syskaseb/robot-cat/hardware/wavego/README.md

# WAVEGO FreeCAD model

`WAVEGO_PRO_BETA_v3.FCStd` is the coloured, non-animated source model.
`WAVEGO_PRO_BETA_v3_motion.FCStd` is its 12-DOF kinematic working copy.

`WAVEGO_component_layout.FCStd` is a separate component-packaging study,
with 26 installation envelopes, measured attachment axes and camera FOV.
See [layout/README.md](layout/README.md) for dimensions, the proposed raised
back, component provenance and collision-test limits. Its coloured boxes
and wireframe enclosures are **not printable mechanical parts**.

`WAVEGO_cat_mechanical.FCStd` is the subsequent PETG mechanical prototype:
a three-part ventilated trunk, the head with its face mask and camera carrier,
the neck saddle, and a servo-driven four-segment tail. It is a work-in-progress
checkpoint, **not released for printing** — see
[mechanics/README.md](mechanics/README.md) for what is and is not verified.
The layout study's clearance results do not certify this later mechanical model.

Every `CAT_*` body in it is generated by
[tools/freecad/wavego_cat_shell.py](../../tools/freecad/wavego_cat_shell.py),
so the geometry is reviewable as a parameter diff and cannot be lost on save.
Rebuild it, and the previews, with:

```bash
freecadcmd tools/freecad/wavego_cat_shell.py
freecadcmd tools/freecad/wavego_cat_render.py
```

Note that `layout/components.json` and `mechanics/components.json` share ids but
**not coordinates** — the layout study's frame is rotated 180 degrees about the
vertical through X=21. The mechanical model uses the one in `mechanics/`.

## Run the motion preview in FreeCAD

1. Open `WAVEGO_PRO_BETA_v3_motion.FCStd`.
2. Run `tools/freecad/WAVEGO_Motion.FCMacro` from **Macro > Macros**.
3. Use the **WAVEGO Motion** dock:
   - **Play trot / Pause** starts or stops the diagonal gait preview;
   - **Stand** restores the imported neutral pose;
   - **Gait phase** scrubs the animation;
   - the 12 numeric fields adjust each servo joint manually;
   - **Show servo axes** displays hip, knee and ankle axes in red, green and blue.

The preview checks hierarchy, ranges and clearances visually. It does not
simulate mass, torque, collisions, ground contact or servo dynamics; those
belong in the ROS 2 / Gazebo model after the CAD motion is accepted.

## Leg/servo mapping

| Leg | Hip | Knee | Ankle |
|---|---:|---:|---:|
| Front right (FR) | 4 | 6 | 10 |
| Front left (FL) | 3 | 8 | 12 |
| Rear right (RR) | 1 | 5 | 9 |
| Rear left (RL) | 2 | 7 | 11 |

The macro is idempotent: running it again reuses the existing kinematic
groups and reopens the controller panel.

## Rigid servo mount correction

Both servo cases in each leg share a rigid group with its two LegLinks.
The upper servo horns are fixed to WConnector; the lower servo horns and
LegSpacer are fixed to the foot bracket. Only the shaft joints articulate.
The macro also migrates the earlier, incorrect hierarchy at the neutral pose.

Verified in FreeCAD: 32 rigid part pairs over 25 gait phases retained their
relative transforms (maximum translation error 5.95e-13 mm, rotation 0 degrees).
Rebuilding from a moving pose also passed. This checks assembly attachment
integrity; it does not certify the imported hole fit or collision clearance.
