syskaseb/robot-cat/hardware/wavego/layout/baseline.png

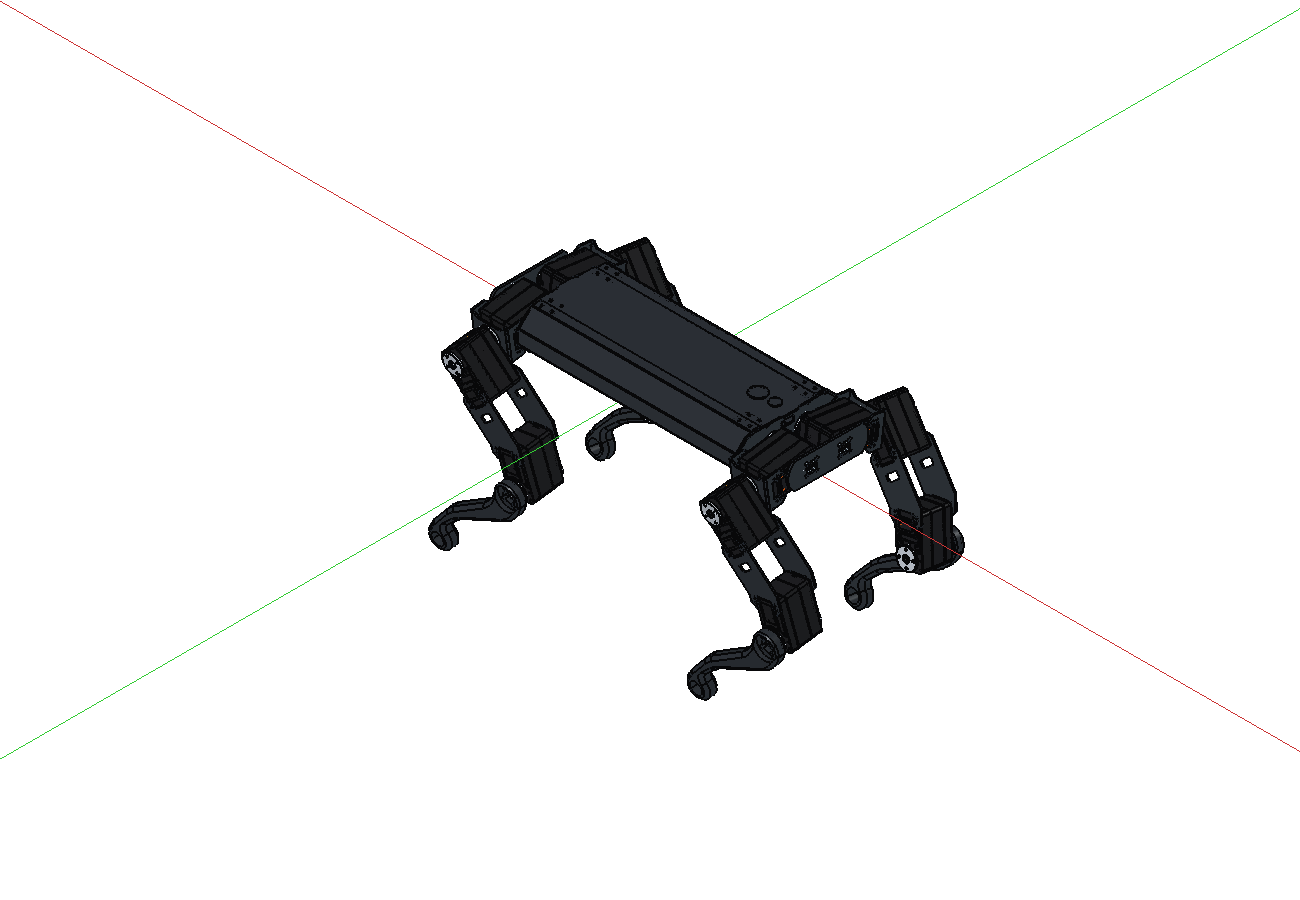
hardware/wavego/layout/baseline.png
