syskaseb/robot-cat/hardware/wavego/layout/layout-head.png

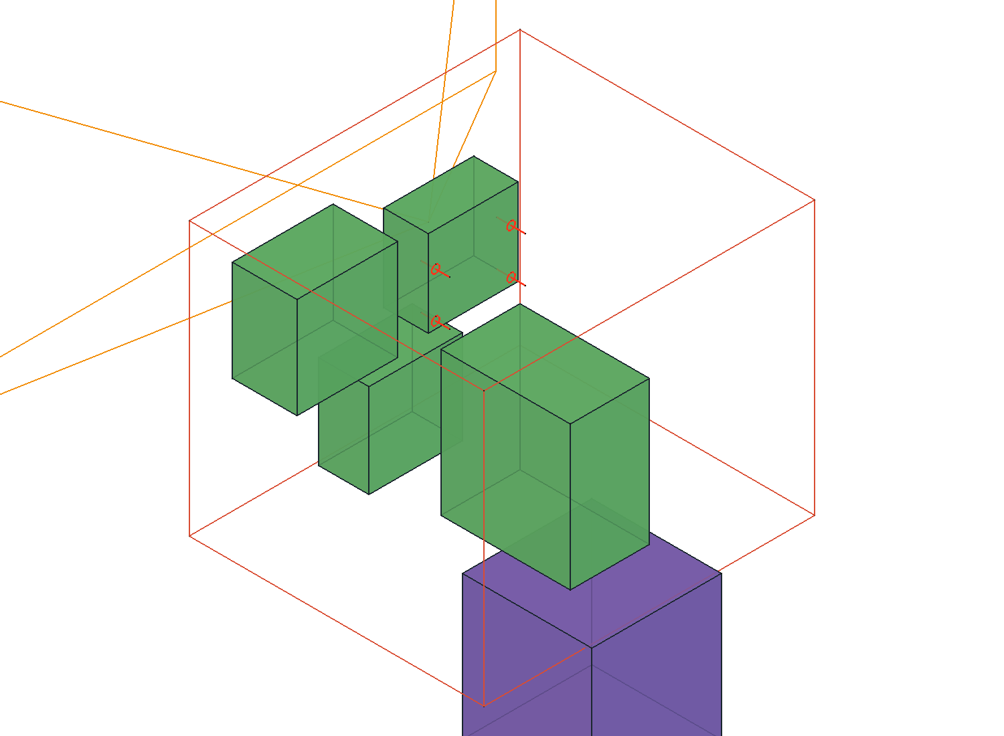
hardware/wavego/layout/layout-head.png
