syskaseb/robot-cat/hardware/wavego/layout/layout-isometric.png

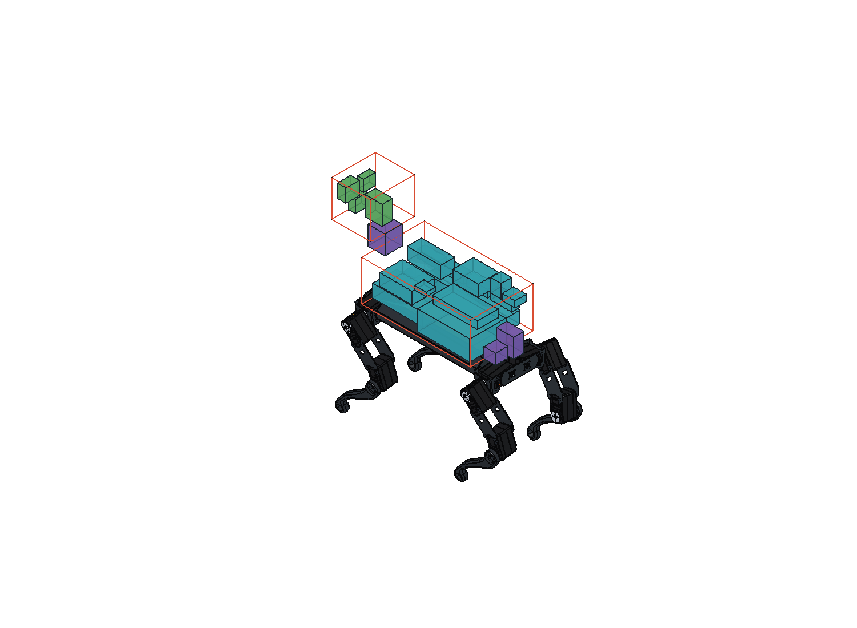
hardware/wavego/layout/layout-isometric.png
