syskaseb/robot-cat/hardware/wavego/layout/layout-lower.png

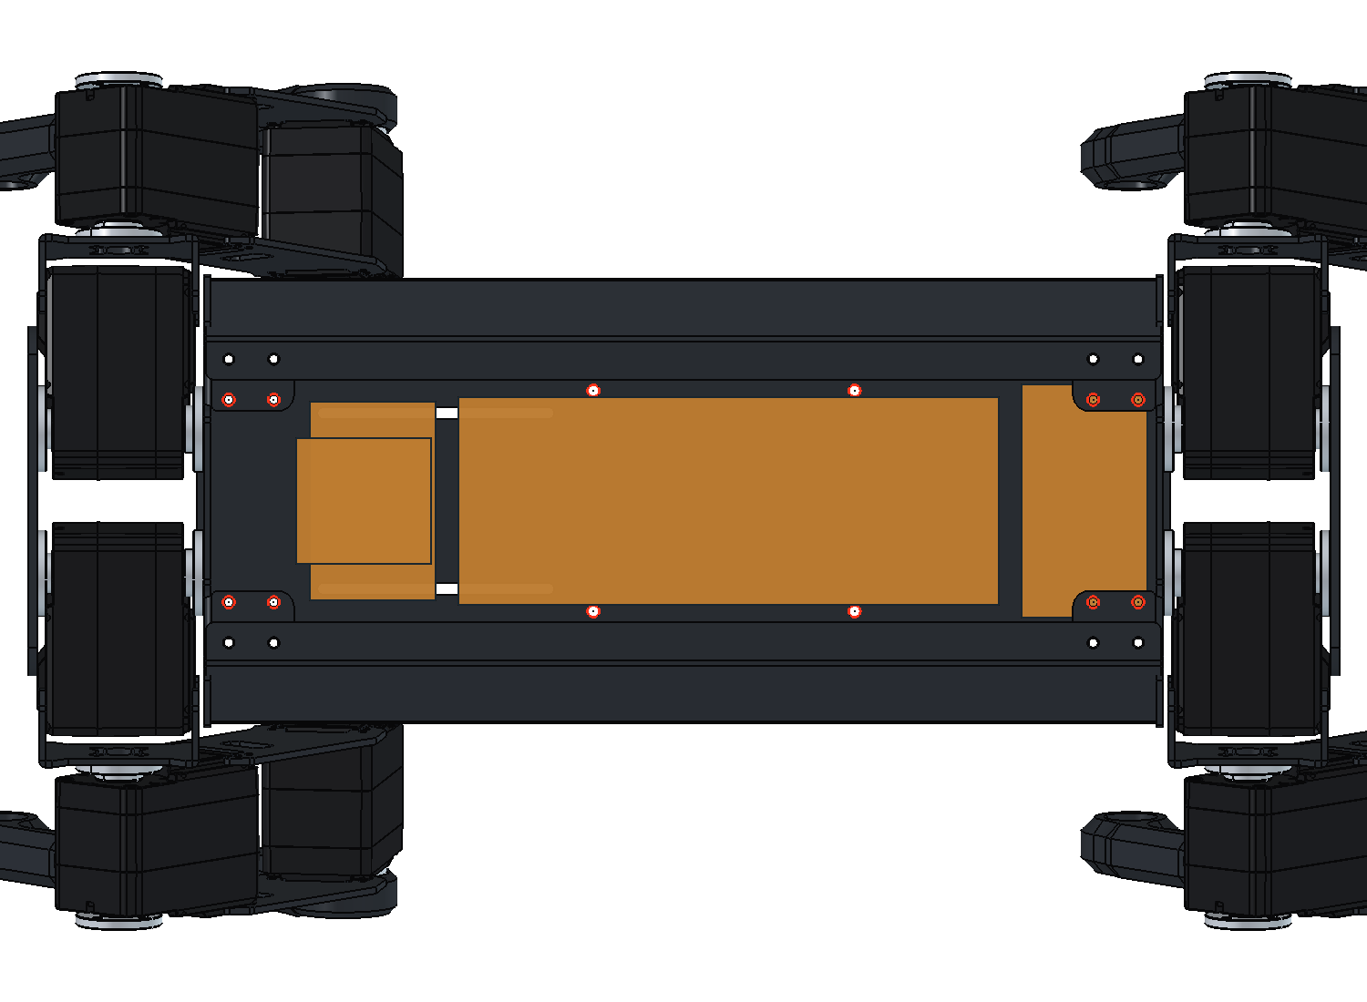
hardware/wavego/layout/layout-lower.png
