syskaseb/robot-cat/hardware/wavego/layout/layout-side.png

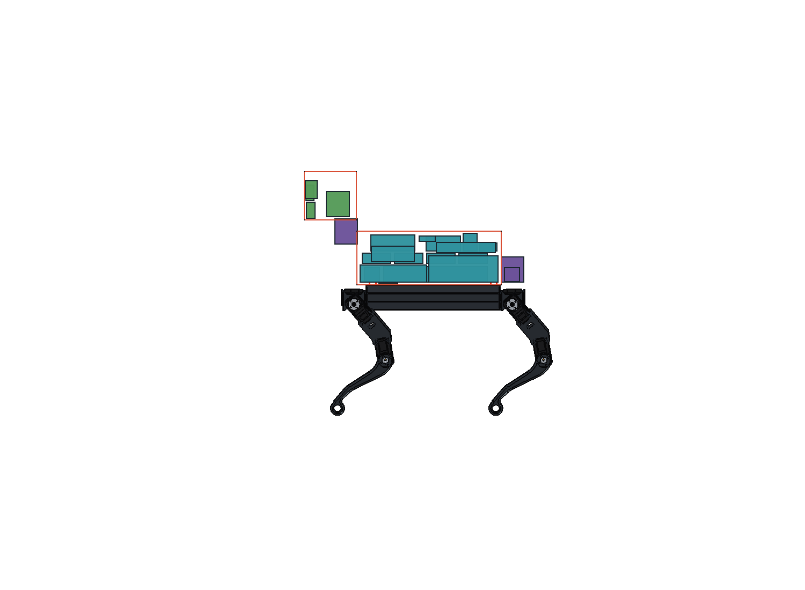
hardware/wavego/layout/layout-side.png
