syskaseb/robot-cat/hardware/wavego/layout/mechanics-progress.png

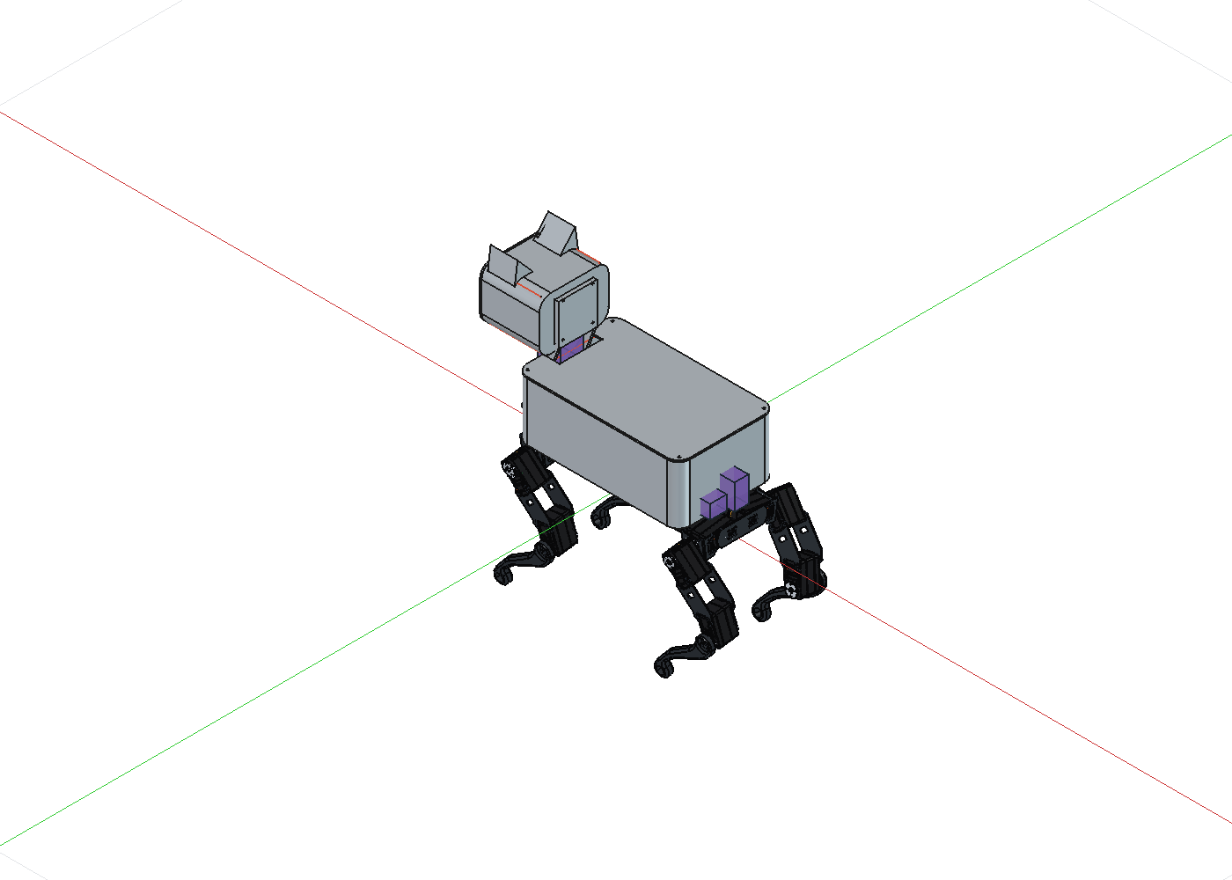
hardware/wavego/layout/mechanics-progress.png
