syskaseb/robot-cat/hardware/wavego/source/robot-cat-backup.png

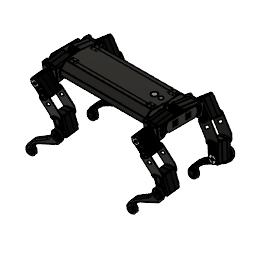
hardware/wavego/source/robot-cat-backup.png
