syskaseb/robot-cat/hardware/wavego/WAVEGO_FreeCAD_iso.png

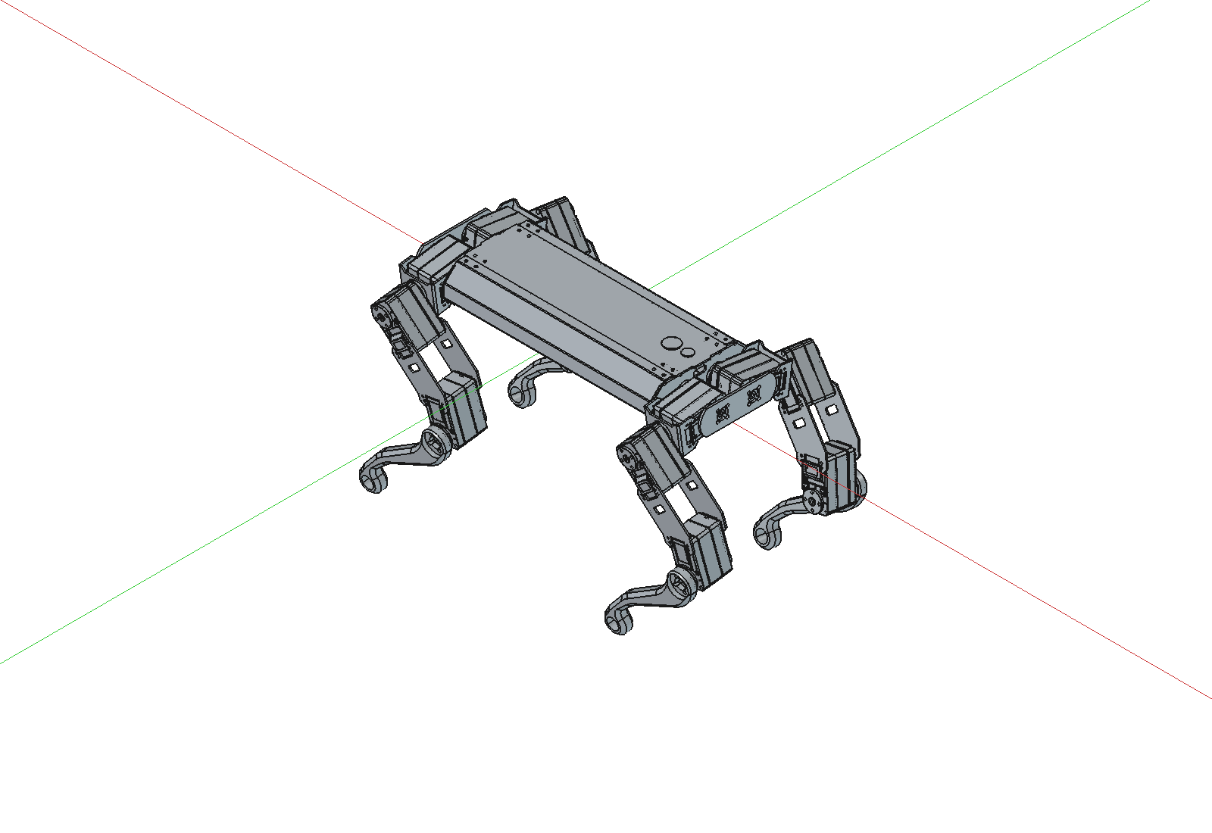
hardware/wavego/WAVEGO_FreeCAD_iso.png
