syskaseb/robot-cat/hardware/wavego/WAVEGO_FreeCAD_materials.png

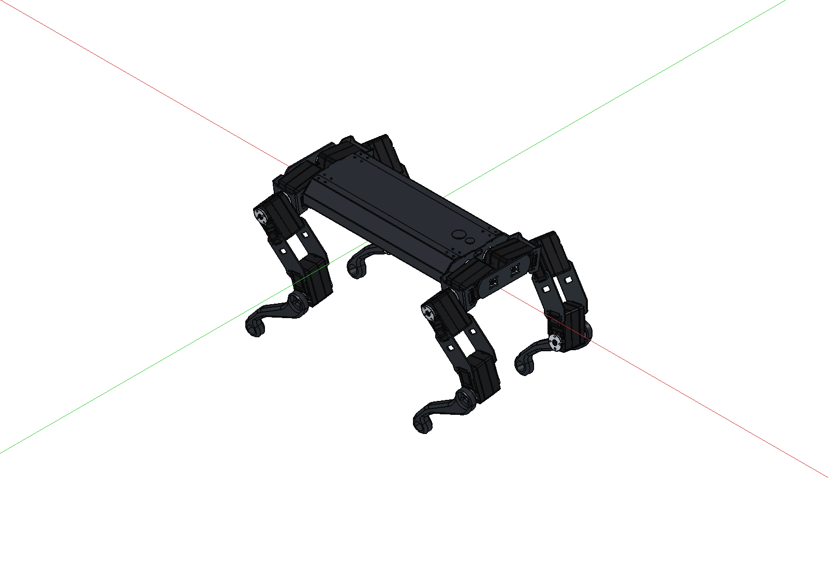
hardware/wavego/WAVEGO_FreeCAD_materials.png
