syskaseb/robot-cat/hardware/wavego/source/WAVEGO_PRO_BETA_v3.step

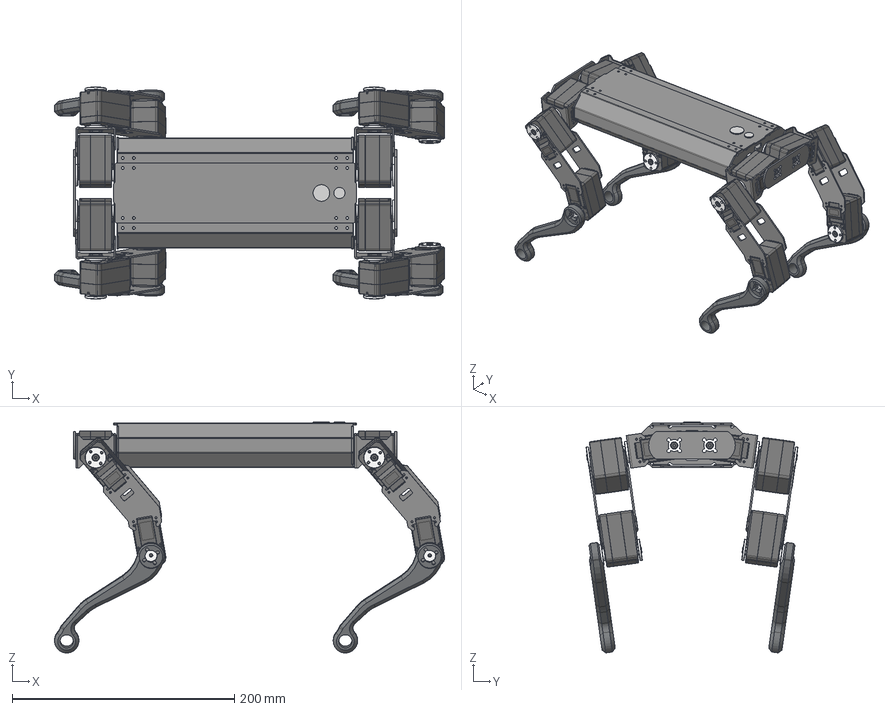
[picture p16: CAD file, 2026-09-04]
hardware/wavego/source/WAVEGO_PRO_BETA_v3.step
351.0 x 190.7 x 207.8 mm
前后盖板 x 2
腿部垫片 x 4
主结构 x 2
侧面板 x 2
腿部连接件 x 8
上下盖板
ZK_122 x 12
SG-ZIJI_15 x 12
XG-ZIJI_16 x 12
MOTOR-1723_3 x 12
PCB-CHAZUO_92 x 12
GE_27 x 12
金属舵盘（驱动） x 12
金属舵盘（从动） x 12
上盖板
W连接件 x 4
支架 x 4
零部件9
