syskaseb/robot-cat/hardware/wavego/WAVEGO_cat_mechanical.FCStd

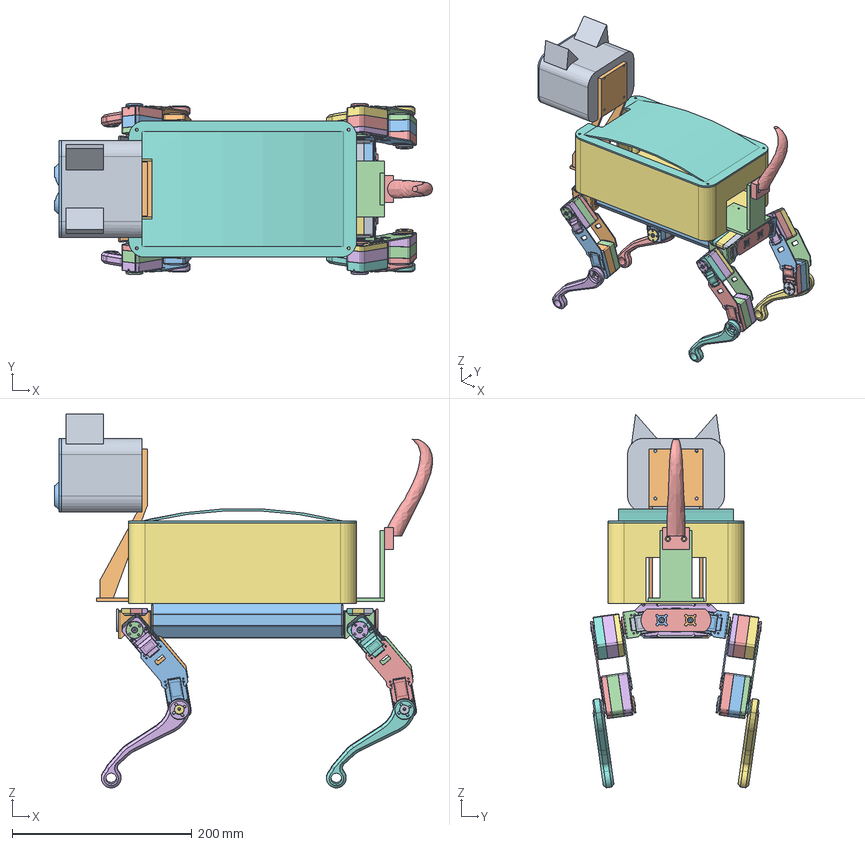
[picture p18: CAD file, 2026-09-09]
hardware/wavego/WAVEGO_cat_mechanical.FCStd
421.0 x 190.7 x 416.2 mm
FrontRearCover
MainFrame
SidePanel
TopBottomCover
ZK_122
SG-ZIJI_15
XG-ZIJI_16
MOTOR-1723_3
PCB-CHAZUO_92
GE_27
ZK_123
SG-ZIJI_001
XG-ZIJI_001
MOTOR-1723_001
PCB-CHAZUO_001
GE_001
ZK_124
SG-ZIJI_002
XG-ZIJI_002
MOTOR-1723_002
PCB-CHAZUO_002
GE_002
ZK_125
SG-ZIJI_003
XG-ZIJI_003
MOTOR-1723_003
PCB-CHAZUO_003
GE_003
FrontRearCover001
MainFrame001
SidePanel001
Bracket_v002
HornDisc_Drive_v009
HornDisc_Idle_v009
LegSpacer001
LegLink
LegLink001
ZK_127
SG-ZIJI_005
XG-ZIJI_005
MOTOR-1723_005
PCB-CHAZUO_005
GE_005
ZK_131
SG-ZIJI_009
XG-ZIJI_009
MOTOR-1723_009
PCB-CHAZUO_009
GE_009
HornDisc_Drive_v003
HornDisc_Idle_v003
WConnector002
HornDisc_Drive_v005
HornDisc_Idle_v005
Bracket_v003
HornDisc_Drive_v011
HornDisc_Idle_v011
LegSpacer003
LegLink002
LegLink003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
