syskaseb/robot-cat/(list of files, cad)

Other CAD files:
hardware/wavego/WAVEGO_PRO_BETA_v3_motion.FCStd
hardware/wavego/WAVEGO_PRO_BETA_v3_colored_backup.FCStd
hardware/wavego/WAVEGO_PRO_BETA_v3_backup.FCStd
hardware/wavego/WAVEGO_PRO_BETA_v3.FCStd
hardware/wavego/source/robot-cat-backup.f3d
