syskaseb/robot-cat/(commit log)

2026-08-20 Simulated quadruped robot cat with arrow-key teleop
    ROS 2 Jazzy + Gazebo Harmonic running natively on Apple Silicon via
    RoboStack, with a 12-DOF cat that walks a trot gait under keyboard control.
    - robot_cat_description: xacro model built from one parameterised leg macro,
    ros2_control wiring and the gz_ros2_control plugin
    - robot_cat_gait: analytic 3-DOF leg IK and trot generation, both ROS-free
    and unit tested, plus the node mapping /cmd_vel to twelve joint positions
    - robot_cat_teleop: arrow-key teleop, decoding split out as a pure function
    - robot_cat_bringup: world, launch files and a camera framed for a 30 cm robot
    Three macOS-specific settings live in pixi.toml and are needed for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
    [cat.ros2_control.xacro, cat.urdf.xacro, cat_world.sdf, controllers.yaml, inertia.xacro, leg.xacro]
2026-08-20 Add an agent-facing runbook and CLAUDE.md pointer
    Someone (or some agent) landing on this repo cold needs more than the human
    quick-start: exact readiness polling, how to drive the cat without a
    keyboard, how to verify motion from the pose rather than the viewport, and
    the gotchas that cost real time (orphaned gait_controller processes after a
    partial kill, set -u breaking colcon's setup.bash, yaw wraparound).
    CLAUDE.md exists only because Claude Code auto-loads it and not README.md -
    it is a short pointer into the Runbook section plus the handful of rules
    most likely to be missed on a first pass.
    🤖 AI Assisted with Claude Code
2026-08-22 Add head/tail teleop control and fix limping gait
    Adds W/A/S/D head pan/tilt and space-stepped tail control, each driven by
    its own ros2_control position controller. Fixes the visible limp that
    appeared once head/tail became actuated: Fast DDS's shared-memory transport
    silently drops /cmd_vel on this machine, tripping the gait watchdog
    mid-stride, so the project now runs on Cyclone DDS. Also rebalances body
    mass to recover the trunk pitch inertia that moved off fixed joints and
    onto the newly free head/tail bodies.
    [cat.ros2_control.xacro, cat.urdf.xacro, controllers.yaml]
2026-08-22 Add a walkable apartment world with a kitchen and living room
    New apartment_world.sdf drops in OpenRobotics' Fuel-hosted "Kitchen and
    Dining" and "Sofa" models (both CC0) so the cat has somewhere more
    interesting than a bare plane to walk. Selected via a new `world` launch
    argument on sim.launch.py; the plain arena remains the default.
    [apartment_world.sdf]
2026-08-22 Add first- and third-person camera views on the v key
    Third-person is Gazebo's own follow, parented behind the cat. First-person
    cannot use follow - follow always aims the camera at its target, so it can
    never look out through the cat's eyes - so the camera pose is instead driven
    directly from the head's world pose at 20 Hz on a background thread, which
    makes W/A/S/D turn the view exactly as they turn the head.
2026-08-22 Give the apartment collision so the cat stops at walls and furniture
    The Fuel kitchen model ships a visual mesh and no collision at all, so the
    cat walked straight through counters and walls. Handing DART the 57k-triangle
    mesh instead segfaults it in CollisionGroup::addShapeFrameImpl, so the
    collisions are boxes derived from the mesh's own sub-object bounds - keeping
    only thin panels (walls) and small-footprint waist-high solids (furniture),
    because the bounds of a whole wall assembly enclose the floor between the
    walls and would seal the cat inside a solid block. A hand-written perimeter
    closes the room.
    Measured: walking into the east wall drops the cat from 0.11 m/s to 0.017 m/s
    with its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
    [apartment_world.sdf]
2026-08-22 Give the cat eyes, and a meow on the m key
    The eyes are cosmetic but sited where a stereo pair would really go, so
    camera sensors can be mounted at the same origins once perception moves to
    Linux - Gazebo cannot run camera sensors on macOS at all (gz-sim#960).
    The meow plays through the host rather than the simulation, because Gazebo
    has no audio component of any kind. The clip is synthesised from a harmonic
    stack under a swept formant filter rather than sampled, which keeps the repo
    self-contained and free of any sample licence, and it is rate-limited: key
    autorepeat would otherwise spawn a player process per repeat.
    [cat.urdf.xacro]
2026-08-22 Add a play-bow stretch on x and a lie-down loaf on p
    Both live in gait_controller, not teleop - the legs already belong to it, so
    teleop only publishes a request (/stretch, /lie_down) and the gait node
    decides what to do with it. Both are pure functions (stretch.py, lie_down.py)
    following gait.py's own pattern, so the pose and timing are unit tested
    without a simulator.
    Stretch is a fixed rise/hold/fall timeline: front feet reach forward and the
    chest drops while the rear legs straighten and shift back, in opposition -
    that opposition is what reads as a bow rather than a crouch. Lie-down is a
    toggle instead, symmetric across all four legs, eased toward a 0/1 target
    rather than following a s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
2026-08-23 Mirror the rear legs' knee so the cat is anatomically right
    Every leg used the front-leg calf range and IK branch, so all four bent the
    same way. A real quadruped's hind knee bends toward the head while the front
    elbow bends toward the tail, and the uniform version read as wrong on sight
    without being easy to name.
    leg.xacro now takes a knee_sign and mirrors the calf joint's own limit range
    for the rear pair; gait.py derives the matching IK sign per leg. The two must
    agree or the IK solves for a branch the joint cannot physically reach.
    Foot placement is unchanged - knee_sign only picks which of the two IK
    solutions reaches a given target - so the gait is untouched. Verified in
    Gazebo: 1.9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
    [cat.urdf.xacro, leg.xacro]
2026-08-23 Give all four legs the same knee, as real quadruped robots have
    Reverts 1559b06, which mirrored the rear calf range and IK branch so the hind
    knees bent toward the head the way a real cat's do. That was correct anatomy,
    but it is not how machines of this class are built: Spot, Unitree and the rest
    put four identical legs on the corners, and matching them is the look we want
    here.
    Mechanically this is the pre-1559b06 arrangement restored in full. knee_sign
    survives as the IK branch selector but is one value for the whole robot again,
    so leg.xacro no longer takes it per leg and gait.py no longer derives it from
    which end of the body a leg is on.
    thigh_lower goes back -1.45 -> -1.20. The wide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
    [cat.urdf.xacro, leg.xacro]
2026-08-23 Splay the paws so the hip roll joints stop being dead weight
    Four of the twelve motors never moved. With every paw directly under its own
    hip, the roll term in leg_ik solves to exactly zero for every pose the gait can
    ask for - measured over a full trot, fl_hip_joint travelled 0.00000 rad. The
    only thing resisting body roll was the width of the hips themselves, and a trot
    balances on one diagonal pair for most of its cycle, so the cat wallowed.
    Measured in cat_world walking straight at 0.15 m/s, body roll peak-to-peak:
    width roll p-p speed
    0.000 7.7 / 8.2 / 10.7 deg 0.095 m/s
    0.010 3.2 deg -
    0.020 0.9 / 2.4 / 2.7 / 3.8 0.1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
2026-08-23 Fix the sofa's absolute path, add a view-angle widget, floor the flat in wood
    Three small world changes.
    The sofa never loaded for anyone but its author. Its <include> pointed at
    file:///Users/alenagler/.gz/fuel/... - a path inside one specific developer's
    home directory - so every other machine failed the whole world with "Unable to
    find uri", taking the apartment down with it rather than just the sofa. It now
    uses the Fuel URL the kitchen mesh already used, which Gazebo resolves through
    its own cache.
    Both worlds gain Gazebo's ViewAngle widget: preset top/front/side/home
    viewpoints and a step-90-degrees button, which the InteractiveViewControl
    mouse bindings alone did not offer. Docked i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
    [apartment_world.sdf, cat_world.sdf]
2026-08-23 Stand the cat on cat-proportioned legs instead of dachshund ones
    The silhouette was wrong in a way that measures: 18.7 cm at the withers over a
    22 cm hip span, a ratio of 0.85. A cat is close to square in profile - about as
    tall at the shoulder as its trunk is long, roughly 24 cm at the withers on a
    real animal - so 0.85 read as a long, low body on short legs.
    Segments go 0.09 -> 0.11 and stance_height 0.13 -> 0.16, which puts the withers
    at 21.7 cm for a ratio of 0.99.
    Those two had to move together. What the gait depends on is not the absolute
    height but how far the knee stays bent, and the old leg stood at 73% of full
    reach. Raising stance_height alone would have taken that to 91% - a n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
    [cat.urdf.xacro]
2026-08-23 Run the tests on every push, on bare Python and in the container
    Two jobs, because the suite splits cleanly in two.
    `maths` needs nothing but pytest. The gait, the IK, the stretch and the
    lie-down are pure functions with no ROS or Gazebo imports, and pytest.ini
    already puts the packages on the path, so 566 of the 581 tests run on a stock
    ubuntu-latest in a couple of seconds. That is the job worth blocking a push
    on.
    `container` covers the remaining 15. camera_view.py imports gz.msgs10 at
    module scope, so those tests cannot run anywhere the Gazebo Python bindings
    are missing - which is every environment except the image run/docker/ builds.
    The container job deliberately calls run/docker/up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
2026-08-23 Walk 3.8x faster: stride and tempo retuned for the longer legs
    The 0.11 m legs were still walking the 0.09 m legs' gait. max_stride 0.08 and
    cycle_time 0.5 were both measured on the old geometry, and the retune had to
    move them together, because each alone goes backwards:
    stride cycle achieved
    0.08 0.5 0.168 m/s old default
    0.16 0.5 0.090 m/s longer stride alone: slower - the leg nears
    its 0.151 m excursion limit and shears
    instead of pushing
    0.16 0.3 0.58-0.64 both together, repeatable
    Heading drift stays at ~1 deg/m, the same rate the old default had, and body
    roll drops to 1.6 d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
2026-08-24 Make body size one knob, and give the trunk a cat's cross-section
    Two changes, both driven by the brief ("ok. 50 centymetrów wysokości i
    przypominał kota") which the model was missing in two different ways.
    Size is now a single parameter threaded through the model and the gait
    together, so it can be chosen by measurement instead of assumed:
    ./run/docker/sim.sh scale:=1.87
    Lengths go as scale, masses as scale^3 and joint effort as scale^4, which is
    how joint torque actually scales - mass times lever arm. cycle_time is the one
    exception and goes as sqrt(scale): a leg is a pendulum, so a bigger animal
    swings it more slowly for the *same* gait. That is the Froude scaling that
    makes a h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
    [cat.urdf.xacro, leg.xacro]
2026-08-24 Separate construction weight from size, and find what the torque really is
    mass_scale is a second knob alongside scale. scale^3 assumes the animal is
    solid with whatever the 3.7 kg original was made of, which turns a 22 cm cat
    into a 24 kg robot at scale 1.87; mass_scale 0.62 models a hollow frame at the
    same dimensions, about what Unitree's Go2 weighs for its size.
    It was added to answer "will a lighter build need smaller actuators", and the
    answer turned out to be no - which is the useful part.
    Measured at 50 cm walking 0.1 m/s, worst joint, 95th percentile:
    24.2 kg 28.6 Nm
    15.0 kg 27.2 Nm
    A 38% mass cut bought 5%. Speed does not help either (0.94 m/s and 0.1 m/s
    land withi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
    [cat.urdf.xacro]
2026-08-24 Keep scale 1.0 as the default: it is already a real cat
    A default of 1.11 was briefly introduced on the strength of a 21.7 cm withers
    figure. That number was stale - it predated deepening the chest to cat
    proportions, and a deeper body sits higher on the same legs. Recomputed from
    the model as it actually stands:
    withers 24.2 cm live cat 24
    mass 3.7 kg live cat 3.6-5.4
    trunk 30 cm
    So scale 1.0 needs no multiplier to be a cat, and 1.11 overshot to 26.9 cm.
    Reverted, with the mistake recorded in the property's comment so the next
    person does not redo it.
    Measured at the restored default, walking 0.1 m/s: worst joint 3.46 Nm at the
    95th percentile, 0.30 Nm media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
    [cat.urdf.xacro]
2026-08-24 Add the v4 actuator report, and the scripts that build it
    The report reverses two recommendations from v3, both because of mistakes in
    v3's own assumptions rather than any new data:
    STS3250 -> ST3215. v3 sized the actuator against the simulation's 3.7 kg.
    A real build is not made of meat: 12 servos at 69 g, a printed PETG shell,
    battery and electronics come to about 2.0 kg. Required torque falls from
    3.46 to 1.87 Nm, which the cheapest bus servo on the shelf covers with 39%
    headroom even on a flat battery - 1308 zl instead of 4980.
    The warning about needing brushless actuators is withdrawn. It came from
    assuming the real robot would be heavier than the model. It is lighter.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
2026-08-24 Add the purchase plan: two versions and a decision
    docs/plan-zakupowy.pdf turns the actuator analysis into something orderable.
    Version A builds a walking cat without sight for 2218 zl; version B adds a
    camera and a distance sensor for 2451 zl. Both fit the original 2500 zl
    budget, because the Raspberry Pi is already owned - the saving is almost
    exactly what vision costs.
    Availability settled which camera. The standard Camera Module 3 is on
    backorder until late October; the wide-angle one ships in 24 hours and, at
    120 degrees against 76, is the better lens for an animal that looks around a
    flat anyway. Paying 47 zl more is not a concession to stock levels.
    The recommendation is to buy the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
2026-08-24 Add assembly, enclosure spec and first-run instructions
    docs/montaz.pdf covers what the purchase plan deliberately left out - the
    plan excluded "screws, bushings and wiring specific to the final CAD", and
    that turned out to hide a few things that would stop the build dead.
    The one that matters most: the bus servo adapter takes power through a
    5.5/2.1 mm barrel jack while the battery ends in an XT60, so nothing connects
    without an adapter cable nobody has ordered. The adapter also ships with no
    cables at all. And the Grove modules Ola picked need Grove-to-DuPont leads,
    because a Raspberry Pi has no Grove sockets - no HAT required, but the leads
    are not optional either.
    The enclosure section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
2026-08-25 Give the cat night vision: NoIR camera, IR illuminator in the other eye
    One eye is the camera, the other its 850 nm illuminator, so the cat sees in
    the dark and the brief's glowing eyes come for free - 850 nm has a faint red
    glow. The wavelength is not a free choice: the VL53L5CX rangefinder works at
    940 nm, so a 940 nm illuminator would shine straight into its passband and
    cut its range. 850 nm sits beside it and the ToF's filter rejects it.
    Cost is the whole remaining budget. Version B goes 2451 -> ~2500 zl against a
    2500 zl limit, so it now lands on the line rather than under it, and that is
    called out rather than buried. Prices were read from the shop in EUR, which
    the pre-order checkli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
    [cat.urdf.xacro]
2026-08-25 Add the compute budget and cooling to the assembly document
    Neither was recorded anywhere, and both constrain the enclosure, so they
    belong here rather than being rediscovered with the printed body in hand.
    Cooling: the Pi throttles at 80 C and PETG softens at about the same
    temperature, so the material of the case gives no headroom over the part it
    is protecting. Vents have to be designed in - they cannot be drilled into a
    finished print - and the lie-down pose turns out to be the only time the
    servos really cool, at 0.09 Nm against 0.70 Nm standing.
    Compute: the processor is not the bottleneck. The gait is trigonometry and
    the IMU fuses on-chip; what runs out is the servo bus. Sync write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
2026-08-25 Say what actually needs soldering, and how the power is wired
    The tools table called a soldering iron mandatory without ever saying what
    for, which leaves someone unable to judge whether this build is within
    reach. It is: the mechanics and all twelve servos are plug-in, and the
    soldering is confined to the power path - the Pololu regulator ships with
    bare through-holes, and XT60 is solder-cup. There is a nearly solder-free
    route too, buying the XT60-to-DC lead ready made and swapping the regulator
    for one with screw terminals, so that is written down rather than left for
    someone to work out on their own.
    Power gets a tree, because there are three voltages and mixing them up is
    expensive: se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
2026-08-25 Put solder, a switch and a fuse on the parts list
    The document called a soldering iron mandatory and never listed solder,
    which is a hard stop on the first evening. The switch and fuse were named in
    a callout as missing rather than being added, so they were easy to read past
    and then not buy.
    Everything else the soldering touches was already covered: the regulator is
    in the power bundle, and XT60, 16 AWG wire, threaded inserts and heat shrink
    are all on the missing-parts list. The callout now explains why the switch
    and fuse matter instead of announcing their absence.
2026-08-25 Explain what the paw pads are actually for
    They were a half-sentence in a table cell - "worth covering with TPU" - which
    reads as a finishing touch. They are not. The model sets foot_mu = 1.2, a
    rubber figure, and every measured speed and drift in these documents was
    taken with it; bare PETG is nearer 0.3-0.4, so without pads the simulation
    stops describing the robot.
    The second job is easier to miss. The actuator report picks servos on the
    95th percentile rather than peak torque, on the grounds that the peaks are
    contact transients "absorbed by mechanical compliance in a real robot" - and
    the soft paw is that compliance. Take it away and the impact lands in the
    gearbox instead, along with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
2026-08-25 Say what can be built before the enclosure exists
    Step 2 assumes an assembled leg, so everything from there down is blocked on
    a CAD design that has not been drawn yet - which reads, wrongly, as the whole
    project being blocked.
    It is not. Addressing the servos, standing the electronics up on the bench,
    running ROS 2 and the gait node with the legs in the air, and measuring the
    real bus read time all need nothing printed at all. That last one is the
    figure chapter 6 explicitly leaves open, and it sets the ceiling on the
    control loop, so it is worth having early.
    Also lists the minimum that does have to be printed to get past step 2: the
    servo brackets, which the community has already solved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
2026-08-26 Add electronics notes and the vision expansion plan
    Two documents from a working session, both generated from tracked scripts like
    the existing three.
    uzupelnienie-elektroniki.pdf covers what the earlier documents left implicit:
    why the servos mount at the joint rather than driven from the body by belts
    (the only gain, lower swing inertia, matters for dynamic gaits, not a 10 cm/s
    walk), why compute is one central board rather than one per leg (a trot needs
    whole-body phase, and each STS servo already runs its own position loop), a
    cost comparison against QDD, and an honest read on gait smoothness — position
    servos with an open-loop gait have a ceiling that no tuning reaches.
    ekspansja-wi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
2026-08-27 Put the real ST3215 and the real masses into the model
    The simulation declared 20 Nm and 20 rad/s in every joint - placeholder
    numbers matching no actuator that can be bought - and carried 3.7 kg of
    scaled cat density rather than a parts list. Both are now the hardware:
    2.57 Nm, which is the ST3215 stall torque at the worst state of a 3S pack,
    and 4.7 rad/s no-load. Head and tail get a microservo's 0.20 Nm instead of
    a leg servo's.
    Masses become the purchase plan, 2.095 kg, distributed by where the parts
    physically sit. The roll servo bolts to the trunk so its mass is the
    trunk's; hip_link carries the thigh servo it swings, thigh_link the knee
    servo, and calf_link is unpowered. That leaves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
    [cat.urdf.xacro]
2026-08-27 Add parametric OpenSCAD parts for the leg and trunk frame
    Six printable parts, everything tied back to the same numbers as
    cat.urdf.xacro and leg_ik.py rather than drawn free-hand: thigh and calf
    segments at 110mm axle-to-axle, the 25mm hip link, a trunk frame at the
    verified 220x110mm hip spacing, a Pi 5 shelf, and a replaceable paw pad.
    Two numbers in params.scad are marked ADJUSTABLE rather than guessed: the
    bracket-to-frame bolt spacing and the servo horn bolt circle. Printables and
    Thingiverse block automated fetches, so the hip bracket's own mounting
    pattern couldn't be pulled and checked the way everything else here was.
    The horn pattern is a real measurement, though - taken from an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
    [calf_segment.scad, helpers.scad, hip_link.scad, leg_assembly.scad, params.scad, paw_pad.scad, pi_shelf.scad, thigh_segment.scad]
2026-08-27 Fix misleading insert_boss wording in the CAD README
    "we wszystkie insert_boss" read as if heat-set inserts belonged to every
    part. They don't - grep confirms insert_boss is instantiated exactly once,
    at the paw stub in calf_segment.scad. Everything else (horn plate, bracket
    plate, Pi shelf) uses plain through-holes. Named the actual location instead
    of the vague plural.
    Claude-Session: https://claude.ai/code/session_01GBkNLAG8VG58owhw5DdrBF
2026-08-27 Give the cat a voice and ears in the purchase plan
    The plan had no microphone at all and a 0.5 W speaker sized for meowing.
    Neither is enough for spoken commands: the Pi 5 has no built-in mic and,
    unlike the 4B, no 3.5 mm jack either.
    Swap the YD36 for the Waveshare 5 W and add a ReSpeaker Lite USB 2-Mic.
    USB, not GPIO, so it does not fight the AI HAT+ for pins. Total goes to
    3917,70 zl.
    Two labels were also lying. The speaker is 100x45x21 mm, which is a third
    of the trunk length and worth seeing in the list rather than discovering
    during assembly. And the IR illuminators ship as a pair while the text
    placed only one, in the second eye socket, leaving the other unaccounted
    for -- say plain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
2026-08-27 Measure the servo instead of guessing it
    params.scad carried two values flagged ADJUSTABLE because no reachable
    source gave the ST3215's hole pattern: Printables and Thingiverse block
    automated access, and the shop pages publish only the outline. The whole
    CAD directory was gated behind "print one hip_link, hold it against a real
    servo, correct four numbers, then print the rest".
    That gate is gone. The SO-ARM100 project ships an official STEP model of
    this servo, and STEP stores holes as analytic CIRCLE entities -- radius and
    centre are exact numbers in the file, no meshing and no eyeballing. Add
    measure/stepdims.py to resolve them and measure/holes.py to do the same for
    an STL by least-squ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
    [helpers.scad, hip_link.scad, params.scad, thigh_segment.scad, trunk_frame.scad]
2026-08-27 Give the cat a skin
    The CAD directory built a robot that walks and had nothing that made it a
    cat. Add the cosmetic layer: body panels, head with ears, joint caps, leg
    fairings and a tail, matching the reference render.
    Kept in its own files and its own namespace, because appearance must not be
    able to quietly change anything the gait depends on. params.scad holds what
    the torque budget was computed on; shell_params.scad holds what it looks
    like and only reads from the other.
    Everything organic is a hull of spheres. The inner offset of such a hull is
    exactly the same hull with every radius reduced by the wall thickness, so a
    constant-thickness shell is two hulls subtracted -- no offset(),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
    [calf_fairing.scad, calf_segment.scad, cat_assembly.scad, ear.scad, head_lower.scad, head_upper.scad, joint_cap.scad, neck_collar.scad]
2026-08-27 Stop verify.py from failing the slow parts it was just given
    The per-part render timeout was 120s, set when every part was a handful of
    cubes and cylinders. The body panels added in the previous commit are CGAL
    booleans between two hulls of seven spheres and take about five minutes
    each, so the first full run since died on shell_back_front with a traceback.
    Raise it to 900s and catch TimeoutExpired so one slow part reports as a
    failed row instead of aborting the whole run. A timeout reads exactly like
    a broken part until you get to the traceback, which is worth a comment.
    A full run is now about an hour, and says so.
2026-08-27 Correct the skin's mass to what verify.py actually renders
    All eighteen parts now pass in one run: watertight, one body each, 837.2g
    of PETG. The skin's own share is 425g, not the 401g recorded when the
    figure was taken - the seam tabs and the enlarged head landed after that
    measurement and nobody went back for it.
    The corrected number moves the conclusion slightly the wrong way: ST3215
    headroom at the end of a 3S discharge is 13%, not 14%. It also puts the
    skin at 425g against the structure's 412g, which is worth stating plainly,
    because "the cosmetic layer costs as much to print as the robot" is a
    different sentence from "the shell adds 400g".
    mass_check.py now carries the verified figur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
2026-08-28 Draw hip_link in the assembly, and add inspection toggles
    cat_assembly.scad imported hip_link.scad but never called it, so every leg
    appeared to start 25mm out from the body with nothing bridging the gap - the
    hip_offset span the part exists to fill. The part was fine; only the preview
    was missing it, which made the hip look like it was floating.
    Two toggles for checking the structure rather than the looks:
    openscad -D show_skin=false -D show_servos=true ... cat_assembly.scad
    show_servos draws each servo in the frame servo_pocket() already uses - origin
    on the output axis, body hanging back behind the horn plate - so a joint can
    be inspected against the part that bolts to it. Both def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
    [cat_assembly.scad]
2026-08-28 Turn the joint plates to face their servo's axis
    A plate bolts flat onto a servo, so its normal IS that servo's output axis.
    Every segment had both plates facing along its own length, which would have
    made each leg joint twist about the leg rather than bend it - the rendered
    legs look like washers threaded on a rod. The three parts differ:
    thigh_segment both joints turn about the lateral axis, so both plates
    rotate 90 degrees.
    calf_segment same, for its one plate. The paw stub keeps its axis.
    hip_link the only place the two axes are perpendicular. case_plate
    was already right - the thigh axis is the direction this
    link spans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
    [calf_segment.scad, cat_assembly.scad, hip_link.scad, thigh_segment.scad]
2026-08-29 Give the cat a face, and separate its limb segments
    The skin read as one smooth loaf on four sticks. Two things were wrong and
    both are about separation.
    The head had no muzzle. It was a taper of the skull, so the face was a
    smooth egg with eyes on it. Give the muzzle its own volume, standing proud
    of the cheeks and sitting below the brow, so there is a step where they
    meet. That step is most of what makes a face read as feline. Stop scaling
    the skull along x while here: a skull whose end you cannot name is a skull
    you cannot place a muzzle against, which is how it fused in the first place.
    The eyes were flat discs down a bore. Make them balls on a flange, pushed
    through from inside and se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
    [calf_fairing.scad, cat_assembly.scad, eye_lens.scad, head_upper.scad, joint_housing.scad, shell_lib.scad, shell_params.scad, thigh_fairing.scad]
2026-08-29 Write down what the skin has to satisfy, for whoever builds it next
    The cosmetic layer keeps coming out looking like a loaf, and the reason is
    structural rather than a matter of taste: the skin is built from convex
    hulls, and a convex hull cannot produce a concavity. A cat is mostly
    concavities - the tuck behind the ribcage, the hollow ahead of the shoulder,
    the dip where the neck meets the chest, the cheek under the eye. None of
    them are reachable with the current tool, so every attempt lands on a
    bulging blob or a string of them.
    Rather than keep tuning radii against that ceiling, write the constraints
    down: the dimensions that pin the torque budget, the measured servo
    geometry, the leg-c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
2026-08-29 Loft the body skin instead of hulling it
    A convex hull cannot produce a concavity, and a cat is mostly concavities:
    the tuck behind the ribcage, the hollow ahead of the shoulder, the belly
    rising towards the rump. Seven hulled spheres could only ever give a bulging
    loaf, and no amount of tuning the radii was going to reach the shape - which
    is why several attempts all landed in the same place.
    Replace them with a lofted mesh. skin/loft.py interpolates a table of
    sections along the spine with a monotone cubic and stitches superellipses
    between them; each section names its half-width, its top and its bottom
    independently, so the width can dip at the waist and the belly can rise
    towards the ta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
    [shell_lib.scad]
2026-08-30 Fill out the haunches, and stop checking a table nobody reads
    Three shape changes, all of them numbers in the loft's section table or in
    shell_params now that the tool stopped being the limit:
    The width was falling away from the waist backwards, which gave a cone for a
    rump. Hold it out to |x| = 126 and drop it late, the way a cat keeps its
    haunches full and tucks in near the tail.
    Limb fairings go from 30 to 34mm at the hip and 26 to 29 at the calf. At the
    old size they read as wire against a 109mm body, which was most of why the
    silhouette looked insect-like even after the joint housings went on.
    The head is carried higher and straighter: the neck leaves the chest 10mm
    further up and 6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
    [shell_lib.scad, shell_params.scad]
2026-09-01 Add a whole-skeleton preview: frame plus all four legs
    Visualisation only, not a printable part. Places leg_assembly-style chains
    at all four real hip corners (hip_x, hip_y from params.scad) hanging
    straight down from trunk_frame, so the six real parts can be seen together
    at true scale and position rather than one at a time.
    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
    [full_preview.scad]
2026-09-01 Remove full_preview.scad, superseded by cat_assembly.scad
    Merged origin/main, which brought measured (not guessed) servo dimensions,
    a lofted body skin, head/ears/tail, and cat_assembly.scad - a proper
    standing-pose preview built from GaitGenerator.stand() angles rather than a
    straight-leg sketch. full_preview.scad predates the hand-mirrored leg
    segments and the new case_plate/horn_plate orientation, so keeping it around
    would mean two whole-robot previews, one of them stale and silently wrong.
    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
    [full_preview.scad]
2026-09-01 Rebuild the whole look against the concept render
    Every previous render deleted, and the cosmetic layer redesigned from zero
    with Ola's concept image as the target. What changed, and what each change
    is for:
    The head is now TWO lofts united by a real mesh boolean - skull and muzzle -
    generated by skin/loft.py alongside the body. The crease where they meet is
    the cheek step that makes a face feline, and it took three tries to place:
    run the muzzle long and low and it reads as a duck bill; leave a gap between
    its top line and the skull's bottom line and the bridge-to-nose join reads
    as an open beak. The face is also FLAT - width held far forward, dropped
    steeply - because on the concept the b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
    [joint_cap.scad, shell_lib.scad, shell_params.scad]
2026-09-01 Give the cat the four features the concept leads with
    Approved from a side-by-side against Ola's render. Each of these is one of
    the things that image does and the CAD did not:
    Eyes go from 19 to 29mm, with eye_ring.scad as a new part - a lit ring
    around each. This is the single strongest change in the cosmetic layer: at
    19mm on an 88mm head the face read as a panther's, and the ring is most of
    what separates iris from the black of the face. Both are cut and trimmed
    against the skull mesh, so the ring beds onto the curve instead of rocking
    on a flat spotface that would break through the cheek.
    ankle_link.scad x4 is a FIXED cosmetic wrist. The concept draws a joint
    there; we have three serv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
    [ankle_link.scad, cat_assembly.scad, eye_ring.scad, head_upper.scad, neck_collar.scad, shell_lib.scad, shell_params.scad]
2026-09-02 Remove legacy CAD design
    [ankle_link.scad, calf_fairing.scad, calf_segment.scad, cat_assembly.scad, ear.scad, eye_lens.scad, eye_ring.scad, head_lower.scad]
2026-09-03 Update shopping plan, soldering decisions and reports
2026-09-04 Replace prototype CAD with WAVEGO FreeCAD model
    [WAVEGO_PRO_BETA_v3.FCStd, WAVEGO_PRO_BETA_v3.step, WAVEGO_PRO_BETA_v3_backup.FCStd, WAVEGO_PRO_BETA_v3_colored_backup.FCStd, robot-cat-backup.f3d]
2026-09-05 Add WAVEGO FreeCAD motion preview
    [WAVEGO_PRO_BETA_v3_motion.FCStd]
2026-09-08 Fix rigid servo mounts in WAVEGO motion model
    [WAVEGO_PRO_BETA_v3_motion.FCStd]
2026-09-09 Checkpoint WAVEGO component layout and PETG cat prototype
    [WAVEGO_cat_mechanical.FCStd, WAVEGO_component_layout.FCStd]
2026-09-09 Regenerate the CAT shell: segmented trunk, domed ears, driven tail
    The mechanical bodies described by the previous checkpoint were not in
    WAVEGO_cat_mechanical.FCStd: CatMechanicalParts was empty, the document
    held no PartDesign::Body at all, and the 26 component envelopes the
    reports measure against were missing too. Rebuild all of it from a
    script so the geometry is a reviewable parameter diff and cannot be lost
    on save again.
    Trunk: a lofted rounded-rectangle skin split into a belt and two upper
    segments, so the front modules or the computer can be reached without
    taking the whole animal apart. Each parting is a thickened collar plus an
    inner tongue with 0.8 mm of slop. Ventilation is ai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
2026-09-10 Record the 25-phase gait sweep: no leg-to-shell collisions
    The trot sweep the previous commit could not report has now run against
    the new geometry. Twenty-five discrete phases, zero hits between the leg
    parts and any generated part, so the wider trunk and the tail arm clear
    the legs through the stride as well as in the neutral pose.
    Scope it honestly in the README: these are sampled poses, not continuous
    motion, and they say nothing about leg deflection under load or about the
    head and tail actuators.
    Claude-Session: https://claude.ai/code/session_01MhXWZYiHc5KS7CL9pHTrFy
